regbundock/2201-Super_TOTI/2201-Super_TOTI.png

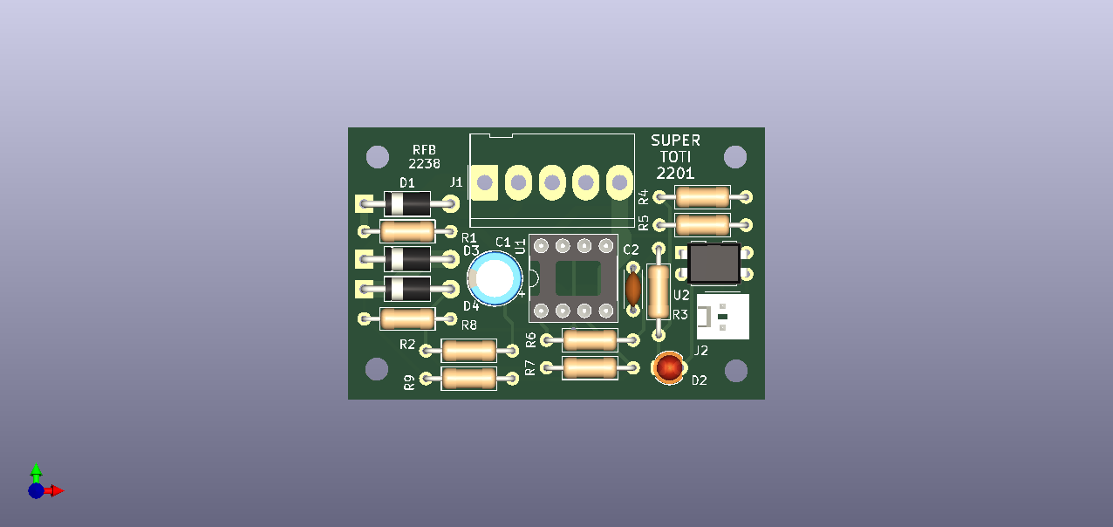
2201-Super_TOTI.png
