regbundock/2201-Super_TOTI/README.md

"# 2201-Super_TOTI" 
A single channel device with the following characteristics.
Powered from the DCC and has a small current drain of ~5mA, has an assured sensitivity of 10K and has a low input impedance of <200 Ohms
