regbundock/2201-Super_TOTI/2201-Super_TOTI.kicad_pcb

## KiCad design 2201-Super_TOTI.kicad_pcb (2022-09-19)

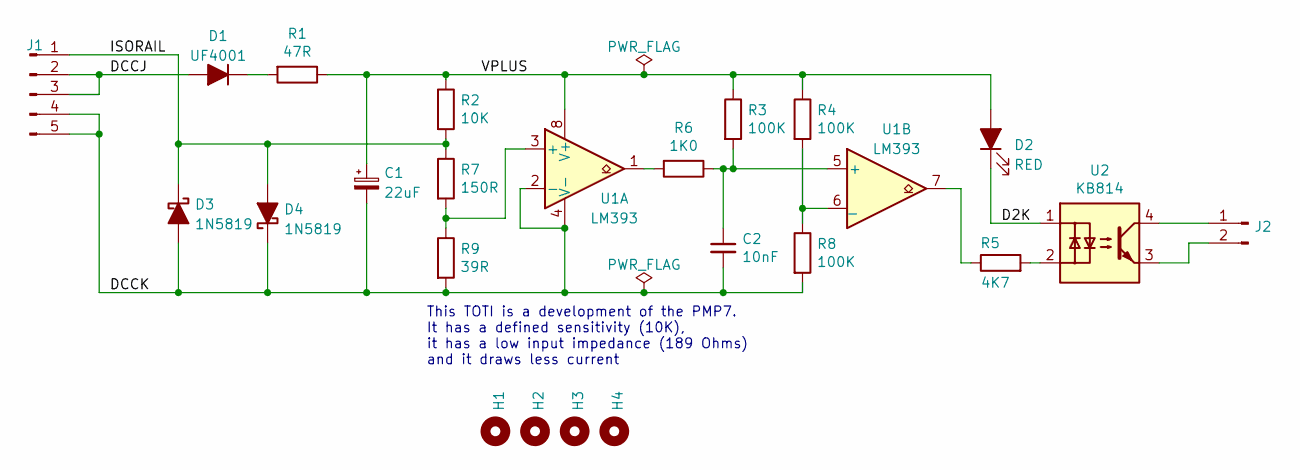
[picture p3: schematic 2201-Super_TOTI.kicad_sch, Super TOTI]

Parts:
C1: 22uF; CP_Radial_D6.3mm_P2.50mm
C2: 10nF; C_Disc_D4.3mm_W1.9mm_P5.00mm
D1: UF4001; D_DO-41_SOD81_P10.16mm_Horizontal
D2: RED; LED_D3.0mm
D3, D4: 1N5819; D_DO-41_SOD81_P10.16mm_Horizontal
H1, H2, H3, H4: MountingHole; MountingHole_2.7mm_M2.5
J1: Conn_01x05_Male; Molex_KK-396_5273-05A_1x05_P3.96mm_Vertical
J2: Conn_01x02_Male; Molex_KK-254_AE-6410-02A_1x02_P2.54mm_Vertical
R1: 47R; R_Axial_DIN0207_L6.3mm_D2.5mm_P10.16mm_Horizontal
R2: 10K; R_Axial_DIN0207_L6.3mm_D2.5mm_P10.16mm_Horizontal
R3, R4, R8: 100K; R_Axial_DIN0207_L6.3mm_D2.5mm_P10.16mm_Horizontal
R5: 4K7; R_Axial_DIN0207_L6.3mm_D2.5mm_P10.16mm_Horizontal
R6: 1K0; R_Axial_DIN0207_L6.3mm_D2.5mm_P10.16mm_Horizontal
R7: 150R; R_Axial_DIN0207_L6.3mm_D2.5mm_P10.16mm_Horizontal
R9: 39R; R_Axial_DIN0207_L6.3mm_D2.5mm_P10.16mm_Horizontal
U1: LM393; DIP-8_W7.62mm_Socket
U2: KB814; DIP-4_W7.62mm

Connections:
/D2K: D2.1 (K), U2.1
/DCCJ: D1.2 (A), J1.2, J1.3
/DCCK: C1.2, C2.2, D3.2 (A), D4.1 (K), J1.4, J1.5, R8.2, R9.2, U1.2 (-), U1.4 (V-)
/ISORAIL: D3.1 (K), D4.2 (A), J1.1, R2.2, R7.1
/VPLUS: C1.1, D2.2 (A), R1.1, R2.1, R3.1, R4.1, U1.8 (V+)
unnamed: C2.1, R3.2, R6.1, U1.5 (+)
unnamed: J2.1, U2.4
unnamed: J2.2, U2.3
unnamed: D1.1 (K), R1.2
unnamed: R4.2, R8.1, U1.6 (_)
unnamed: R6.2, U1.1
unnamed: R7.2, R9.1, U1.3 (+)
unnamed: R5.1, U1.7
unnamed: R5.2, U2.2

Notes on the sheet:
This TOTI is a development of the PMP7. It has a defined sensitivity (10K), it has a low input impedance (189 Ohms) and it draws less current

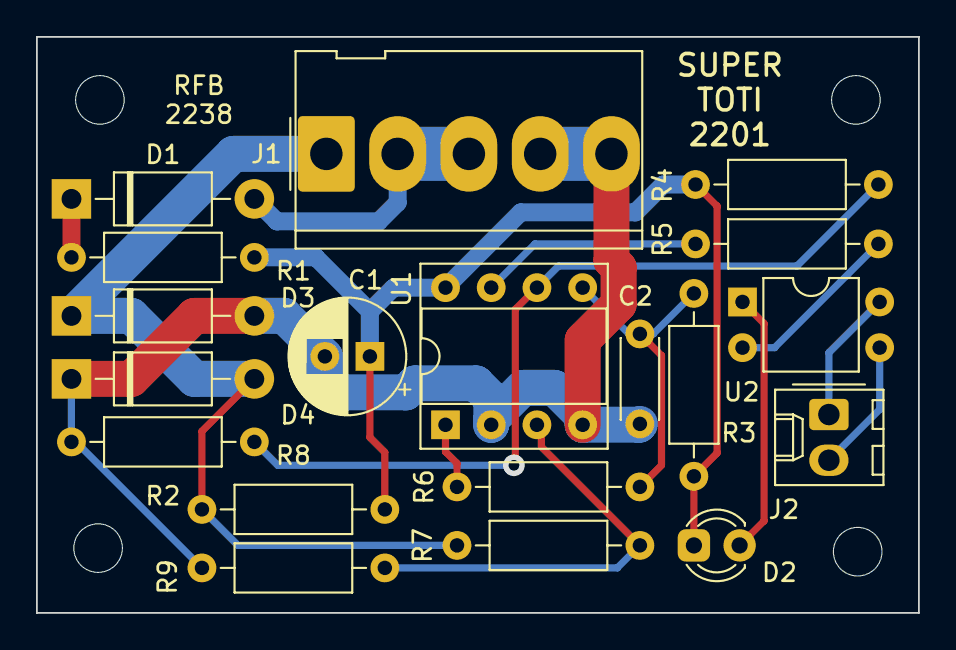
[picture p4: board 2201-Super_TOTI.kicad_pcb from above]

Board: 2 copper layers, 49.0 x 32.0 mm, 23 parts (0 on the bottom side), 14 nets.
